bchang3/ece445-roomify/README.md

# Roomify: A Smart Room System 
ECE 445 Senior Design Project

## PCB Captures
### AC-DC PSU
AC-DC_CONVERTER

### IR Repeater
IR_REPEATER

### Control Board
IR_BOX
