bchang3/ece445-roomify/ecad/README.md

### ECAD Files
KiCad Version 9.0.7 Files for all 3 PCBS
