bchang3/ece445-roomify/notebooks/wklam2/README.md

# Warren's Log

## 2026-02-05 - System Level Definitions


## 2026-02-06 - Component Selection (Repeater)
IR LED: SFH 4546 (950nm)\
IR Receiver: TSOP38238 (950nm)\
MCU: ATTiny85\
Fet Switches: SI2342DS-T1-GE3 (8 VDS and 6 Id)\
Gate Driver: DGD0211CWT-7 (Low Side Gate Driver)\
Battery: 9V at 3Wh

### Expected Power
SFH 4546 emits 130mW/sr at 38kHz. Expected dBm output will be $10 \cdot \log_{10}(130) = 21.1$. With the receiver having a minimum power of -5dbm, we have a margin of around 26 dBm. Our targeted distance of a 20 foot radius will be satisfied by our link margin.

### Current Schematic

To be changed:
- Pi filter to tune for the 38kHz signal

## 2026-02-11 
### Repeater Link Budgeting
From previous calculations, we expected 130mW/sr, but the solid angle of our IR led has a size of around $20mm^2$ which will allow us to find that the solid angle $\Omega = \frac{A}{d^2}$. For our expected distance of around 10 meters, we get a solid angle of $\Omega = \frac{20 \cdot 10^{-6}}{10^2}$. From here, we get an expected output of $130 \cdot 2 \cdot 10^{-7}$. This gives us a power of -45 dBm. However, for our receiver, it has a receive power of 15mW/sr. Given that the diameter of the IR receive led is similar, following the same calculations, we get that the expected receive power is -55 dBm. This gives us a link budget of around 10 dB. With an insertion loss of around 0.5 dB for PLA (the material we will 3D print our repeater in), we have a budget of around 9.5 dB for traveling throughout the air. This will give us a large amount of margin for our device.

### Isolation for Offline
Examined the difference between full wave bridge rectifier or center tap transformer for rectification. The efficiency of a center tap XFMR would be higher than the full wave and also include less voltage drops across the diodes, but it is more expensive. It would bypass the need for a flyback transformer, but at 60 Hz, the transformer would be rather large. It would be a trade off and something to look into for a smaller transformer that is rated for higher frequencies (which allows us to use our FB converter) and reduce footprint while maintaining isolation between our high and low voltage circuits.
\
Diagram to help show the current flow diagram.\
\
Diagram of full hardware level diagram.

## 2026-02-11 
### Power Budgeting
On our main logic board inside the box, we are using an LT1170 as a DC-DC converter. This IC allows us to have a wide input voltage and an output of 3v3. Because Roomify will have two MCUs (one “main” MCU and one special MCU for controlling the touchscreen display, we will need around 2.4A to power both (assuming a peak current draw of 1.2A for an ESP32-S3). Roomify will drive at most three infrared LEDs at a time at 200mA pulses, requiring peak draw of 600mA. 

Combining the current requirements for the MCUs and the IR LEDs gives a total budget of 3A. The rating for the LT1170 is 5A at 3v3. For our 12V system that powers our 3v3 system, it is required to output around 10 Watts. Our flyback converter can deliver up to 40 Watts of power, so we will have an ample amount of power for our system. Below is a simulation of our LT1170 component that delivers enough voltage and current.

### Repeater
I was able to add a reverse protection NMOS circuit to our input of our battery. This helps us protect us from shorting out our LDO and any DC-DC power converters of our board.


### Major Revision
Revised the 12V line to be a 24V line. We realized that for a flyback transformer, the the ratios determined the sizing of our voltage step up and down. We want a 4:1:1 transformer, so that requires a 24V line. Since the LT1170 can handle input of up to 60V, a 24V input will not affect it.

## 2026-02-12
### DC-DC 24V-3V3 Converter
Simulation completed and component selection
\
Tested with a load of varying current to mirror a MCU with a varying load and current draw. Peaking at around 3V6 which is the rated maximum of our MCU. Might look into ways to reduce Q factor of our system as well as set a 3V3 limit with possible TVS diode or others. Average steady state voltage of around 3V2.
\
Results when dropping cap values to reduce Q. Peaking went from 3V6 to around 3V4~3V5, but has much more ripple. Will adjust when design our board.

## 2026-02-15
### AC-DC 120VAC-24VDC Converter
Simulation is competed and component selection
\
The tested configuration has the load low enough impedance to draw a large enough current so the converter can work smoothly. We designed it such that it has a 0.8A output at 24V giving us 19W to play with. This coveres our link budget.\
(NOTE: do NOT use a standard LTspice NMOS...)

## 2026-02-17
### AC-DC Schematic
The schematic for AC-DC 120VAC to 24VDC\

### DC-DC Schematic
The schematic for the DC-DC 24VDC to 3V3DC\
Note: This converter is floating as ground is not tied to the actual GND. It acts as a high side switch and is bootstrapped.

### Modification to Design
After realizing that our AC-DC converter needs to be enclosed in a metal container for safety reasons for grounding, placing an antenna inside would be a poor decision. From here, we decided to split our power module into 2 separate boards and design each one differently. The AC-DC converter will be its own board and have its own container. From here, we can have a wire harness connect the 24VDC rail between our AC-DC and main Controller Unit. In the controller unit, we will be able to handle the 24V-3V3 Regulation easier without the worry of a farday cage enclosing our antenna.

## 2026-02-20
MCU Schematic + IR LED



## 2026-02-25
### AC-DC 
To revise our AC-DC PSU to fit the requirements, we were able to add a soft start to the device so that the capacitor would not blow up with a large amount of current inrush. To do so, we added an NTC at the input to increase the resistance that would go to our C1 and C2. In addition to this, we added a fuse to limit the amount of current that would go into the system.


## 2026-03-01
### Layout
Worked on PCB Layout for both the IR repeater and AC-DC. In the IR Repeater layout, focused on having the ability to create a good GND reference layer for the USB signal

On AC-DC layout, worked on Isolation between the VOUT and VIN sections.

## 2026-03-05
### Layout
Worked on PCB layout for MCU board as well as the AC-DC PSU. On the AC-DC PSU, recreated the LT Spice simulations to include the effects of the NTC at start as well as operation period. 

With the addition of the resistor at the input, was able to monitor the RC and if any ringing was occuring during the start up phase. On the PCB Layout for MCU, began routing the USB as well as the connections between each IR Led.

## 2026-03-10
### MCU Board
On the MCU board, I added capabilities for over 14 IR LED to be controlled. This will give us the ability to select different locations as each IR LED has a very direct field and scope. 

Now, the board has ability to select each different IR LED based off of location and a software mapping.

## 2026-03-13
### Layout 
Worked on MCU Layout for all IR Repeaters

Added ability for power via 24V rail and USB-C at 5V

## 2026-03-20
### Worked on AC-DC Layout


## 2026-03-27
### Soldering
Soldered on the MCU for both IR repeater and MCU


## 2026-04-02
### Soldering
Added power componenets to repeater board and MCU board


## 2026-04-06
### Soldering
Components added with USB-C capabililities


## 2026-04-08
### Debug
DC-DC buck converter issue on 9V for battery for IR Repeater

Resulted in large spike when the power is turned on, causes large transient. Needed to add TVS diode for 3v3 protection.

## 2026-04-10
### Solder
AC-DC Soldering


## 2026-04-15
### AC-DC Validation
Test with 2V output from AC-DC converter


## 2026-04-21
### IR Testing
We tested the transmit power of our IR LED and ran into a huge problem of the range. When transmitting the signal with WiFi capabilities, the range decreases to around 10 inches of range, but when the transmission is done with a hard-coded value, it can transmit for a few feet. This caused us to narrow down the issue to the MCU itself and the compute power. It is fighiting for compute power for the WiFi POST requests to our API while also transmitting a signal at 38kHz. This causes the signal to not be sent well.

### Hardware Modifications
Added 100uF capacitors next to each 3v3 rail that will be transmitting IR signals. This is to help mitigate the dropping of any power when transmitting signals as each pulse pulls around 1A so it can cause brown out in our voltage if not properly addressed.

## 2026-04-25
### AC-DC Validation

Issue with the output. Had a large oscillation with swings to both postive and negative values showing an issue with the directionality. Possible cause was the Y-Grounding which caused a massive issue with an oscillating ground.

### IR Transmitter Validation

Validation of signal being transmitted with correct NEC code. From here, we tested the range and got over 20 feet of range with our design.
