bchang3/ece445-roomify/mcu/mcu/main/main.ino

#include "arduino_secrets.h" 
#include <WiFi.h>
#include "API.h"
#include "Transceiver.h"

String boardSerial = SERIAL_NUMBER;

unsigned long lastPollTime = 0;
const unsigned long pollInterval = 500;

void setup() {
  Serial.begin(115200);
  connectToWifiAndServer();
  initTransceiver();
}

void loop() {
  if (millis() - lastPollTime > pollInterval) {
    pollCommands(boardSerial);
    lastPollTime = millis();
  }
}
