bchang3/ece445-roomify/mcu/display/main/Icons.h

#ifndef ICONS_H
#define ICONS_H

// 'house', 40x40px
const unsigned char epd_bitmap_house [] PROGMEM = {
	0x00, 0x00, 0x00, 0x00, 0x00, 0x00, 0x00, 0x00, 0x00, 0x00, 0x00, 0x00, 0x7e, 0x00, 0x00, 0x00, 
	0x00, 0xff, 0x00, 0x00, 0x00, 0x01, 0xff, 0x80, 0x00, 0x00, 0x07, 0xe7, 0xe0, 0x00, 0x00, 0x0f, 
	0xc3, 0xf0, 0x00, 0x00, 0x1f, 0x81, 0xf8, 0x00, 0x00, 0x3f, 0x00, 0xfc, 0x00, 0x00, 0x7c, 0x00, 
	0x3e, 0x00, 0x00, 0xf8, 0x00, 0x1f, 0x00, 0x03, 0xf0, 0x00, 0x0f, 0xc0, 0x07, 0xe0, 0x00, 0x07, 
	0xe0, 0x0f, 0xc0, 0x00, 0x03, 0xf0, 0x0f, 0x80, 0x00, 0x01, 0xf0, 0x1e, 0x00, 0x00, 0x00, 0x70, 
	0x1e, 0x00, 0x00, 0x00, 0x78, 0x1e, 0x00, 0x00, 0x00, 0x78, 0x1e, 0x00, 0xff, 0x00, 0x78, 0x1e, 
	0x03, 0xff, 0xc0, 0x78, 0x1e, 0x03, 0xff, 0xc0, 0x78, 0x1e, 0x07, 0xff, 0xe0, 0x78, 0x1e, 0x07, 
	0x81, 0xe0, 0x78, 0x1e, 0x07, 0x81, 0xe0, 0x78, 0x1e, 0x07, 0x81, 0xe0, 0x78, 0x1e, 0x07, 0x81, 
	0xe0, 0x78, 0x1e, 0x07, 0x81, 0xe0, 0x78, 0x1e, 0x07, 0x81, 0xe0, 0x78, 0x1e, 0x07, 0x81, 0xe0, 
	0x78, 0x1e, 0x07, 0x81, 0xe0, 0x78, 0x1e, 0x07, 0x81, 0xe0, 0x78, 0x1e, 0x07, 0x81, 0xe0, 0x78, 
	0x0e, 0x07, 0x81, 0xe0, 0x78, 0x0f, 0xff, 0xff, 0xff, 0xf0, 0x0f, 0xff, 0xff, 0xff, 0xf0, 0x07, 
	0xff, 0xff, 0xff, 0xe0, 0x01, 0xff, 0xff, 0xff, 0x00, 0x00, 0x00, 0x00, 0x00, 0x00, 0x00, 0x00, 
	0x00, 0x00, 0x00, 0x00, 0x00, 0x00, 0x00, 0x00
};
// 'circle-plus', 52x52px
const unsigned char epd_bitmap_circle_plus [] PROGMEM = {
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
	0x80, 0x06, 0x6f, 0xe0, 0x0e, 0x61, 0xf8, 0x1c, 0x70, 0x7c, 0x18, 0x30, 0xfc, 0x00, 0x39, 0xf8, 
	0x00, 0x1b, 0x80, 0x00, 0x1b, 0x00, 0x00, 0x0f, 0x00, 0x00, 0x0f, 0x00, 0x00, 0x0f, 0x00, 0x00, 
	0x06, 0x00, 0x00, 0x00, 0x00, 0x00, 0x00, 0x00
};

// 'circle-plus 24', 24x24px
const unsigned char epd_bitmap_circle_plus_24 [] PROGMEM = {
	0x00, 0x00, 0x00, 0x00, 0x7e, 0x00, 0x03, 0xff, 0xc0, 0x07, 0x81, 0xe0, 0x0e, 0x00, 0x70, 0x1c, 
	0x00, 0x38, 0x38, 0x00, 0x1c, 0x30, 0x18, 0x0c, 0x30, 0x18, 0x0c, 0x60, 0x18, 0x06, 0x60, 0x18, 
	0x06, 0x61, 0xff, 0x86, 0x61, 0xff, 0x86, 0x60, 0x18, 0x06, 0x60, 0x18, 0x06, 0x30, 0x18, 0x0c, 
	0x30, 0x18, 0x0c, 0x38, 0x00, 0x1c, 0x1c, 0x00, 0x38, 0x0e, 0x00, 0x70, 0x07, 0x81, 0xe0, 0x03, 
	0xff, 0xc0, 0x00, 0x7e, 0x00, 0x00, 0x00, 0x00
};

#endif
