bchang3/ece445-roomify/mcu/display_presets/main/Icons.h

// 'wand-sparkles', 48x48px
const unsigned char epd_bitmap_wand_sparkles [] PROGMEM = {
	0x00, 0x00, 0x00, 0x00, 0x00, 0x00, 0x00, 0x00, 0x00, 0x00, 0x00, 0x00, 0x00, 0x00, 0x18, 0x00, 
	0x07, 0x80, 0x00, 0x00, 0x3c, 0x00, 0x1f, 0xe0, 0x00, 0x00, 0x7e, 0x00, 0x3f, 0xf0, 0x00, 0x00, 
	0xff, 0x00, 0x7f, 0xf8, 0x00, 0x00, 0xff, 0x00, 0xff, 0xf8, 0x00, 0x00, 0x7e, 0x01, 0xfc, 0xfc, 
	0x00, 0x00, 0x3c, 0x03, 0xf8, 0x7c, 0x00, 0x00, 0x18, 0x07, 0xf0, 0x7c, 0x00, 0x60, 0x00, 0x0f, 
	0xe0, 0xfc, 0x00, 0xf0, 0x00, 0x1f, 0xc1, 0xf8, 0x00, 0xf0, 0x00, 0x3f, 0x83, 0xf8, 0x00, 0xf0, 
	0x00, 0x7f, 0x07, 0xf0, 0x07, 0xfe, 0x00, 0xfe, 0x0f, 0xe0, 0x0f, 0xff, 0x01, 0xff, 0x1f, 0xc0, 
	0x0f, 0xff, 0x03, 0xff, 0xbf, 0x80, 0x07, 0xfe, 0x07, 0xf7, 0xff, 0x00, 0x00, 0xf0, 0x0f, 0xe3, 
	0xfe, 0x00, 0x00, 0xf0, 0x1f, 0xc1, 0xfc, 0x00, 0x00, 0xf0, 0x3f, 0x83, 0xf8, 0x00, 0x00, 0x60, 
	0x7f, 0x07, 0xf0, 0x00, 0x00, 0x00, 0xfe, 0x0f, 0xe0, 0x00, 0x00, 0x01, 0xfc, 0x1f, 0xc0, 0x00, 
	0x00, 0x03, 0xf8, 0x3f, 0x80, 0x00, 0x00, 0x07, 0xf0, 0x7f, 0x00, 0x00, 0x00, 0x0f, 0xe0, 0xfe, 
	0x06, 0x00, 0x00, 0x1f, 0xc1, 0xfc, 0x0f, 0x00, 0x00, 0x3f, 0x83, 0xf8, 0x0f, 0x00, 0x00, 0x7f, 
	0x07, 0xf0, 0x0f, 0x00, 0x00, 0xfe, 0x0f, 0xe0, 0x7f, 0xe0, 0x01, 0xfc, 0x1f, 0xc0, 0xff, 0xf0, 
	0x03, 0xf8, 0x3f, 0x80, 0xff, 0xf0, 0x07, 0xf0, 0x7f, 0x00, 0x7f, 0xe0, 0x0f, 0xe0, 0xfe, 0x00, 
	0x0f, 0x00, 0x1f, 0xc1, 0xfc, 0x00, 0x0f, 0x00, 0x1f, 0x83, 0xf8, 0x00, 0x0f, 0x00, 0x3f, 0x07, 
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
};

// Array of all bitmaps for convenience. (Total bytes used to store images in PROGMEM = 1216)
const int epd_bitmap_allArray_LEN = 4;
const unsigned char* epd_bitmap_allArray[4] = {
	epd_bitmap_music_4,
	epd_bitmap_palette,
	epd_bitmap_sparkles,
	epd_bitmap_wand_sparkles
};
