bchang3/ece445-roomify/mcu/display/main/RemoteDetails.h

#ifndef REMOTEDETAILS_H
#define REMOTEDETAILS_H

#include <Arduino.h>
#include <Arduino_GFX_Library.h>
#include <Fonts/FreeSansBold12pt7b.h>
#include "Transceiver.h"
#include "Models.h"
#include "AppState.h"
#include "API.h"
#include "UI.h"
#include "Remotes.h"
#include "Icons.h"
#include "Colors.h"
#include "Transceiver.h"


extern Arduino_GFX *gfx; 

extern RemoteButton activeButtons[24]; 
extern int activeButtonCount;

void drawRemoteDetails(int index);
void drawRemoteButtons(int btnStartY);
void handleDetailsTouch(int tx, int ty);

#endif
