bchang3/ece445-roomify/mcu/mcu/main/arduino_secrets.h

#ifndef ARDUINO_SECRETS
#define ARDUINO_SECRETS
// #define SECRET_SSID "BenjiPhone"
// #define SECRET_PASS "beomjaemin"
#define SERIAL_NUMBER "917a595fba5dba86"
// #define SECRET_SSID "IllinoisNet_Guest"
// #define SECRET_PASS ""
#define SECRET_SSID "Suites at Third"
#define SECRET_PASS "ShadowArmadillo1"
#endif
