bchang3/ece445-roomify/mcu/display/main/Colors.h

#ifndef COLORS_H
#define COLORS_H

#define WHITE             0xFFFF // White
#define COLOR_NAV_BG      0x2104 // Very Dark Gray
#define COLOR_NAV_BORDER  0x4208 // Medium Gray
#define COLOR_NAV_TEXT    0xFFFF // White
#define COLOR_TEXT        0x0000 // Black
#define COLOR_REMOTE_CARD 0x1948 // Slate Blue
#define COLOR_ACCENT      0x041F // Roomify Blue
#define COLOR_ERROR       0xF800 // Red
#define COLOR_DISABLED    0x7BEF // Grayed out

#endif
