bchang3/ece445-roomify/(commit log)

2026-04-07 add buttons get endpoint
2026-04-07 small ui changes, switch supabase calls to hitting server endpoints, and add server endpoints for queuing web app commands
2026-04-07 fix pressbutton to log command and not button id
2026-04-21 add device header to command triggers
2026-04-26 switch from storing spotify tokens in cookies to supabase and update python server endpoints
2026-04-27 move cookies to supabase, add preset editing, and update server to get board polling status
2026-04-27 fix board status endpoint
2026-04-27 fix insert into buttons error
2026-04-27 update device header
2026-05-08 add arduino code
